jejor/ECE411-Fall2020/Schematics/README.md

# Eagle Schematics & Boards

## Valve Indicator

Purpose:
This board will collect valve position data using hall effect sensors mounted on nine solenoid valves and will report the current commanded state of the valves. 
The processor will compare the expected valve states with the currect reported valve states, 
if the states do not match the processor will output an indication over the LED arrays.
The LED arrays will display specific binary codes to indicate which valve does not match. 
If multiple valves do not match then the LED arrays will display all binary codes one after another based upon priority information.

Inputs:
- POE+ 24V Power
- UART Data
- Nine Hall Effect Sensors
- ST-Link V2 Emulator

Processor:
- STM32F042K

Outputs:
- Three LED Arrays
- One Buzzer
- SD Card Data Backup

### Libraries In Use

- Power Regulators: Diodes Inc. - AZ34063UMTR-G1.lbr
- Test Points: oresat-misc.lbr
- Processor: U-ST-STM32F042K-uC.lbr
- JTAG Emulator Connector: J-Samtec-FTSH-105-XXX-DV-K-ARM-SWD.lbr
- Diode: On Semiconductor - 1N5819G.lbr

### Design Rules

We are using the OshPark design rules for a 2-layer board.
