jejor/ECE411-Fall2020/Schematics/ece411_schemas/valve_indicator.brd

## EAGLE design Schematics/ece411_schemas/valve_indicator.brd (2020-12-07)

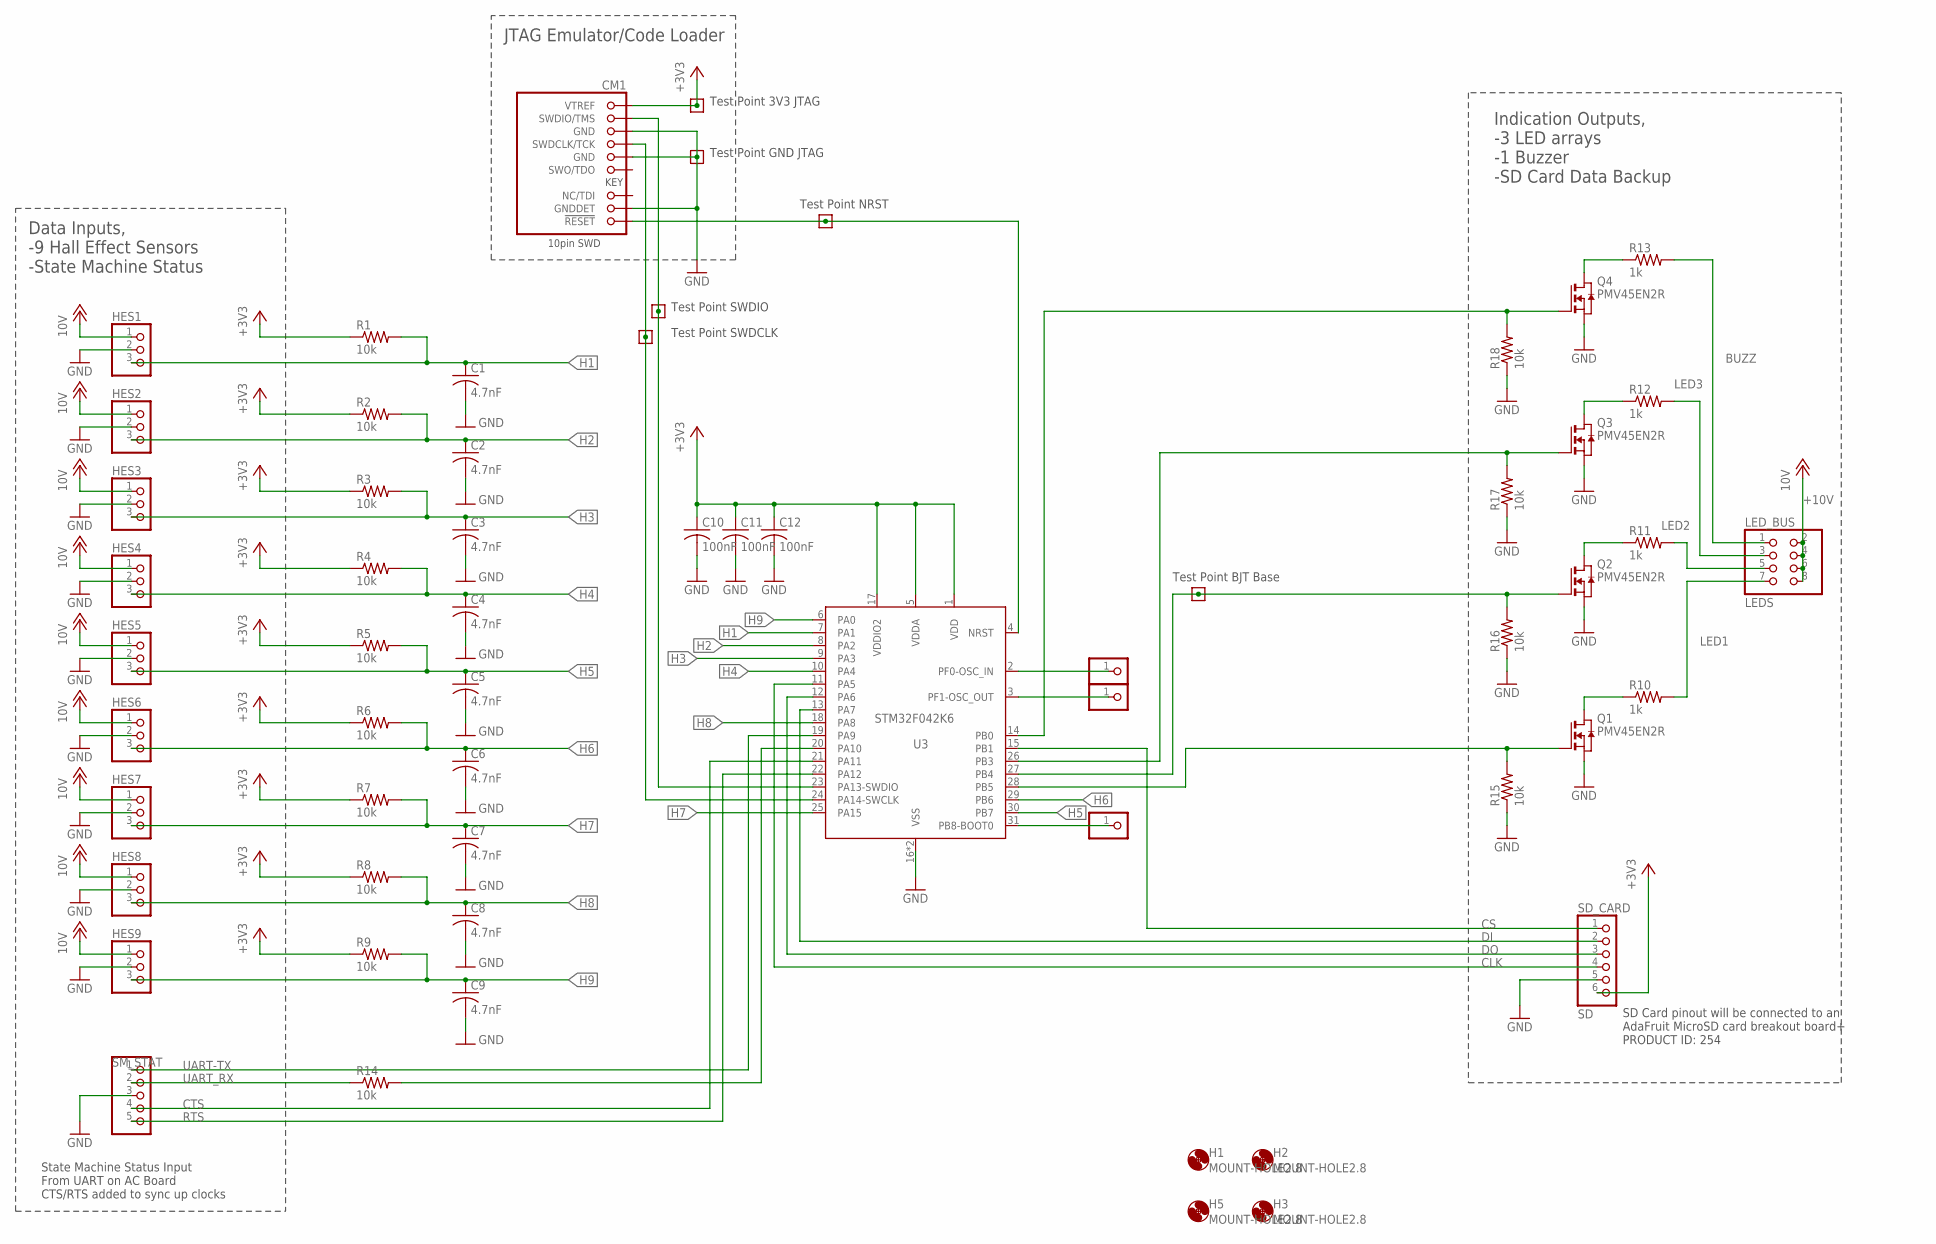
[picture p5: schematic valve_indicator.sch, sheet 1, Processor]

Parts:
C1, C2, C3, C4, C5, C6, C7, C8, C9: 4.7nF; C0603; MPN C1608C0G1H472J080AA
C10, C11, C12: 100nF; C0603; MPN CL10B104KA8NNNC
CM1: FTSH-105-XX-X-DV-K; CON10_2X5_DUK_FTSH; MPN FTSH-105-01-F-DV-K-TR
H1, H2, H3, H5: MOUNT-HOLE2.8; 2,8
HES1: HES1; 1X03; MPN 0022112032
HES2: HES2; 1X03; MPN 0022112032
HES3: HES3; 1X03; MPN 0022112032
HES4: HES4; 1X03; MPN 0022112032
HES5: HES5; 1X03; MPN 0022112032
HES6: HES6; 1X03; MPN 0022112032
HES7: HES7; 1X03; MPN 0022112032
HES8: HES8; 1X03; MPN 0022112032
HES9: HES9; 1X03; MPN 0022112032
JP2: PF0-OSC_IN_PIN; 1X01
JP3: PF1-OSC_OUT_PIN; 1X01
JP4: PB8-BOOT0_PIN; 1X01
LED_BUS: LEDS; 2X04
Q1, Q2, Q3, Q4: PMV45EN2R; SOT23; MPN PMV45EN2R
R1, R2, R3, R4, R5, R6, R7, R8, R9, R14, R15, R16, R17, R18: 10k; R0603; MPN RMCF0603FT10K0
R10, R11, R12, R13: 1k; R0603; MPN RMCF0603JJ1K00
SD_CARD: SD; 1X06; MPN 5-103635-5
SM_STAT: SM_STAT; 1X05; MPN 0022112032
TP3V3J: TEST-POINT-LARGE-SQUARE; 1X01
TPBASE: TEST-POINT-LARGE-SQUARE; 1X01
TPJGND: TEST-POINT-LARGE-SQUARE; 1X01
TPNRST: TEST-POINT-LARGE-SQUARE; 1X01
TPSCLK: TEST-POINT-LARGE-SQUARE; 1X01
TPSIO: TEST-POINT-LARGE-SQUARE; 1X01
U3: STM32F042K6; QFP32-7X7; MPN STM32F042K6T6

Connections:
+3V3: C10.1, C11.1, C12.1, CM1.1 (VTREF), R1.1, R2.1, R3.1, R4.1, R5.1, R6.1, R7.1, R8.1, R9.1, SD_CARD.6, TP3V3J.1, U3.1 (VDD), U3.5 (VDDA), U3.17 (VDDIO2); also elsewhere on the board
+10V: HES1.1, HES2.1, HES3.1, HES4.1, HES5.1, HES6.1, HES7.1, HES8.1, HES9.1, LED_BUS.2, LED_BUS.4, LED_BUS.6, LED_BUS.8; also elsewhere on the board
BUZZ: LED_BUS.1, R13.2
CLK: SD_CARD.4, U3.11 (PA5)
CS: SD_CARD.1, U3.15 (PB1)
CTS: SM_STAT.4, U3.21 (PA11)
DI: SD_CARD.2, U3.13 (PA7)
DO: SD_CARD.3, U3.12 (PA6)
GND: C1.2, C2.2, C3.2, C4.2, C5.2, C6.2, C7.2, C8.2, C9.2, C10.2, C11.2, C12.2, CM1.3 (GND), CM1.5 (GND), CM1.9 (GNDDET), HES1.2, HES2.2, HES3.2, HES4.2, HES5.2, HES6.2, HES7.2, HES8.2, HES9.2, Q1.2 (S), Q2.2 (S), Q3.2 (S), Q4.2 (S), R15.1, R16.1, R17.1, R18.1, SD_CARD.5, SM_STAT.3, TPJGND.1, U3.16 (VSS), U3.32 (VSS); also elsewhere on the board
H1: C1.1, HES1.3, R1.2, U3.7 (PA1)
H2: C2.1, HES2.3, R2.2, U3.8 (PA2)
H3: C3.1, HES3.3, R3.2, U3.9 (PA3)
H4: C4.1, HES4.3, R4.2, U3.10 (PA4)
H5: C5.1, HES5.3, R5.2, U3.30 (PB7)
H6: C6.1, HES6.3, R6.2, U3.29 (PB6)
H7: C7.1, HES7.3, R7.2, U3.25 (PA15)
H8: C8.1, HES8.3, R8.2, U3.18 (PA8)
H9: C9.1, HES9.3, R9.2, U3.6 (PA0)
LED1: LED_BUS.7, R10.2
LED2: LED_BUS.5, R11.2
LED3: LED_BUS.3, R12.2
unnamed: Q4.3 (D), R13.1
unnamed: JP2.1, U3.2 (PF0-OSC_IN)
unnamed: JP3.1, U3.3 (PF1-OSC_OUT)
unnamed: JP4.1, U3.31 (PB8-BOOT0)
unnamed: CM1.4 (SWDCLK/TCK), TPSCLK.1, U3.24 (PA14-SWCLK)
unnamed: Q3.3 (D), R12.1
unnamed: Q1.1 (G), R15.2, U3.28 (PB5)
unnamed: Q3.1 (G), R17.2, U3.26 (PB3)
unnamed: Q1.3 (D), R10.1
unnamed: Q2.3 (D), R11.1
unnamed: CM1.2 (SWDIO/TMS), TPSIO.1, U3.23 (PA13-SWDIO)
unnamed: CM1.10 (!RESET), TPNRST.1, U3.4 (NRST)
unnamed: Q4.1 (G), R18.2, U3.14 (PB0)
unnamed: Q2.1 (G), R16.2, TPBASE.1, U3.27 (PB4)
RTS: SM_STAT.5, U3.22 (PA12)
UART-RX: R14.2, U3.20 (PA10)
UART-TX: SM_STAT.1, U3.19 (PA9)
UART_RX: R14.1, SM_STAT.2

Notes on the sheet:
State Machine Status Input From UART on AC Board CTS/RTS added to sync up clocks
Data Inputs, -9 Hall Effect Sensors -State Machine Status
Indication Outputs, -3 LED arrays -1 Buzzer -SD Card Data Backup
JTAG Emulator/Code Loader
Test Point 3V3 JTAG
Test Point GND JTAG
Test Point NRST
Test Point SWDCLK
Test Point SWDIO
Test Point BJT Base
SD Card pinout will be connected to an AdaFruit MicroSD card breakout board+ PRODUCT ID: 254

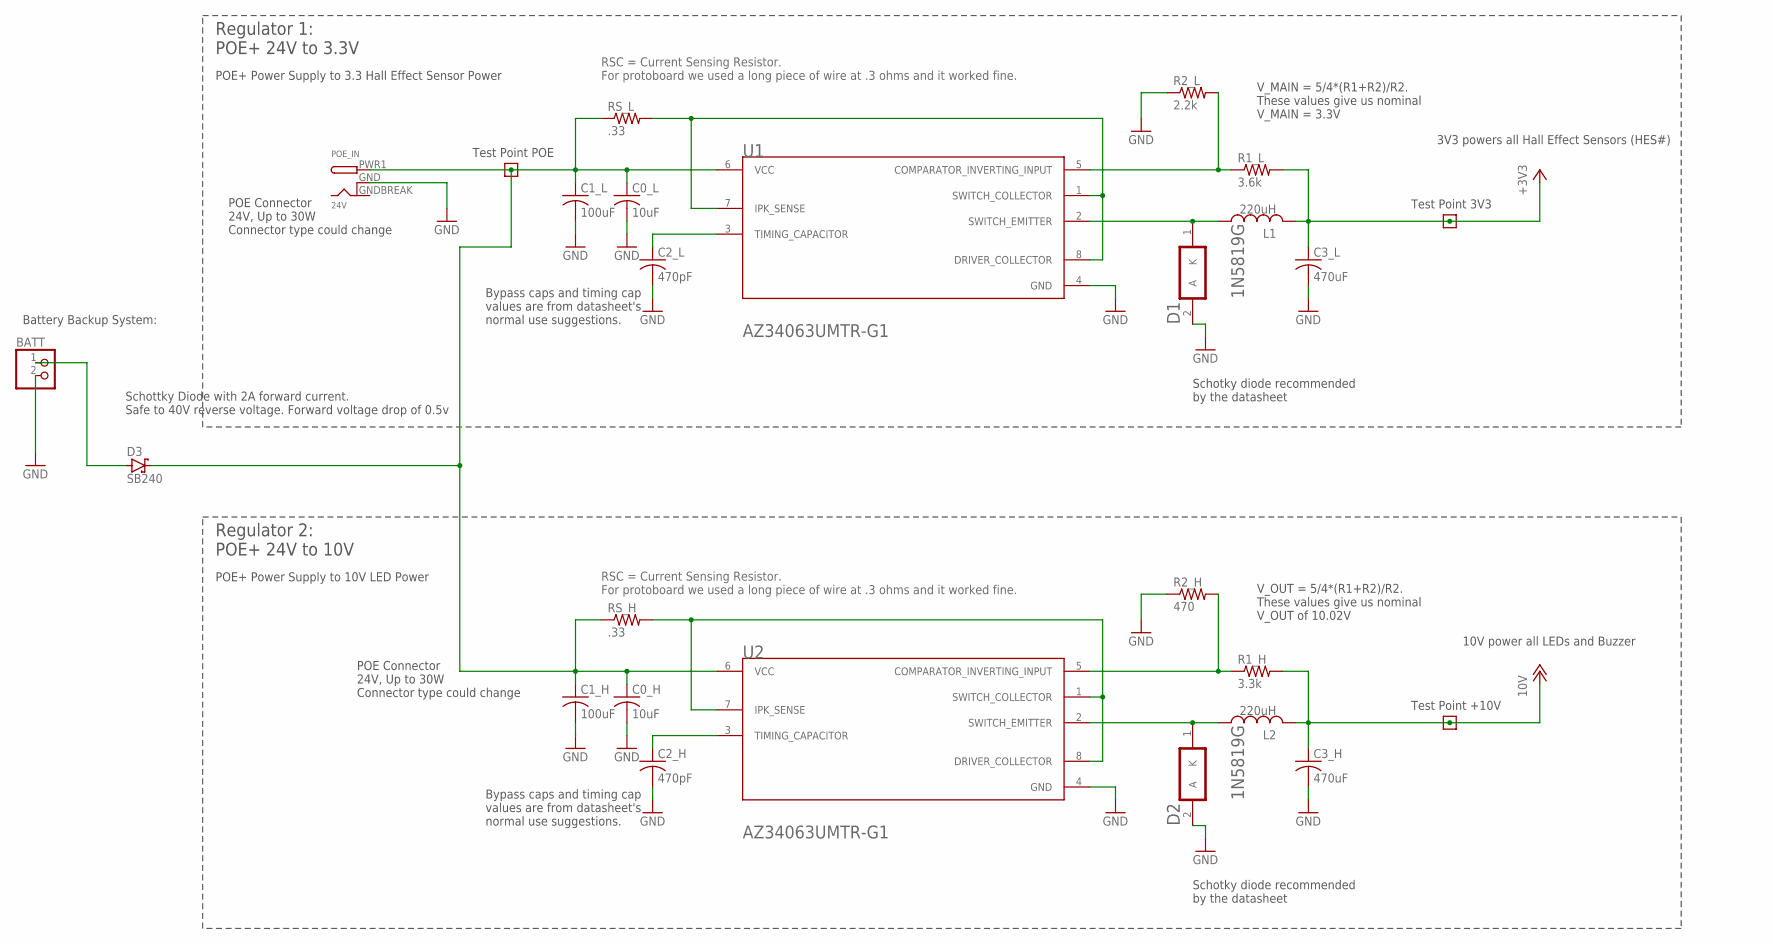
[picture p6: schematic valve_indicator.sch, sheet 2, Power Regulators]

Parts:
BATT: LED1; 1X02; MPN 0022232021
C0_H, C0_L: 10uF; C1206; MPN CL31A106MBHNNNE
C1_H, C1_L: 100uF; C025-025X050; MPN 107CKR050M
C2_H, C2_L: 470pF; C0603; MPN 0603B471K500CT
C3_H, C3_L: 470uF; C025-025X050; MPN ESH477M050AH4AA
D1, D2: 1N5819G_0_0; ON_SEMICONDUCTOR_1N5819G_0
D3: SB240; DO41-7.6; MPN SB240-E3/54
L1, L2: 220uH; 0204/5; MPN 12RS224C
POE_IN: 24V; DCJACK_2MM_SMT
R1_H: 3.3k; R0603; MPN RC0603FR-073K3L
R1_L: 3.6k; R0603; MPN RC0603FR-073K6L
R2_H: 470; R0603; MPN CRGCQ0603F470R
R2_L: 2.2k; R0603; MPN ERJ-3EKF2201V
RS_H: .33; R0603; MPN ERJ-3RQFR33V
RS_L: .33; R0603; MPN ERJ-3RQFR33V
TP3V3, TP10V: TEST-POINT-LARGE-SQUARE; 1X01
TPOE: TEST-POINT-LARGE-SQUARE; 1X01
U1, U2: AZ34063UMTR-G1; DIODES_INC._AZ34063UMTR-G1_0

Connections:
+3V3: C3_L.1, L1.2, R1_L.2, TP3V3.1; also elsewhere on the board
+10V: C3_H.1, L2.2, R1_H.2, TP10V.1; also elsewhere on the board
GND: BATT.2, C0_H.2, C0_L.2, C1_H.2, C1_L.2, C2_H.2, C2_L.2, C3_H.2, C3_L.2, D1.2 (A), D2.2 (A), POE_IN.GND (GNDBREAK), POE_IN.GNDBREAK (GND), R2_H.1, R2_L.1, U1.4 (GND), U2.4 (GND); also elsewhere on the board
unnamed: RS_L.2, U1.1 (SWITCH_COLLECTOR), U1.7 (IPK_SENSE), U1.8 (DRIVER_COLLECTOR)
unnamed: C2_L.1, U1.3 (TIMING_CAPACITOR)
unnamed: R1_L.1, R2_L.2, U1.5 (COMPARATOR_INVERTING_INPUT)
unnamed: D1.1 (K), L1.1, U1.2 (SWITCH_EMITTER)
unnamed: D2.1 (K), L2.1, U2.2 (SWITCH_EMITTER)
unnamed: BATT.1, D3.A
unnamed: RS_H.2, U2.1 (SWITCH_COLLECTOR), U2.7 (IPK_SENSE), U2.8 (DRIVER_COLLECTOR)
unnamed: C2_H.1, U2.3 (TIMING_CAPACITOR)
unnamed: R1_H.1, R2_H.2, U2.5 (COMPARATOR_INVERTING_INPUT)
POE: C0_H.1, C0_L.1, C1_H.1, C1_L.1, D3.C, POE_IN.PWR1 (PWR), RS_H.1, RS_L.1, TPOE.1, U1.6 (VCC), U2.6 (VCC)

Notes on the sheet:
POE Connector 24V, Up to 30W Connector type could change
Bypass caps and timing cap values are from datasheet's normal use suggestions.
V_MAIN = 5/4*(R1+R2)/R2. These values give us nominal V_MAIN = 3.3V
Schotky diode recommended by the datasheet
Regulator 1: POE+ 24V to 3.3V
3V3 powers all Hall Effect Sensors (HES#)
POE+ Power Supply to 3.3 Hall Effect Sensor Power
V_OUT = 5/4*(R1+R2)/R2. These values give us nominal V_OUT of 10.02V
Regulator 2: POE+ 24V to 10V
10V power all LEDs and Buzzer
POE+ Power Supply to 10V LED Power
Battery Backup System:
Schottky Diode with 2A forward current. Safe to 40V reverse voltage. Forward voltage drop of 0.5v
Test Point 3V3
Test Point +10V
Test Point POE
RSC = Current Sensing Resistor. For protoboard we used a long piece of wire at .3 ohms and it worked fine.

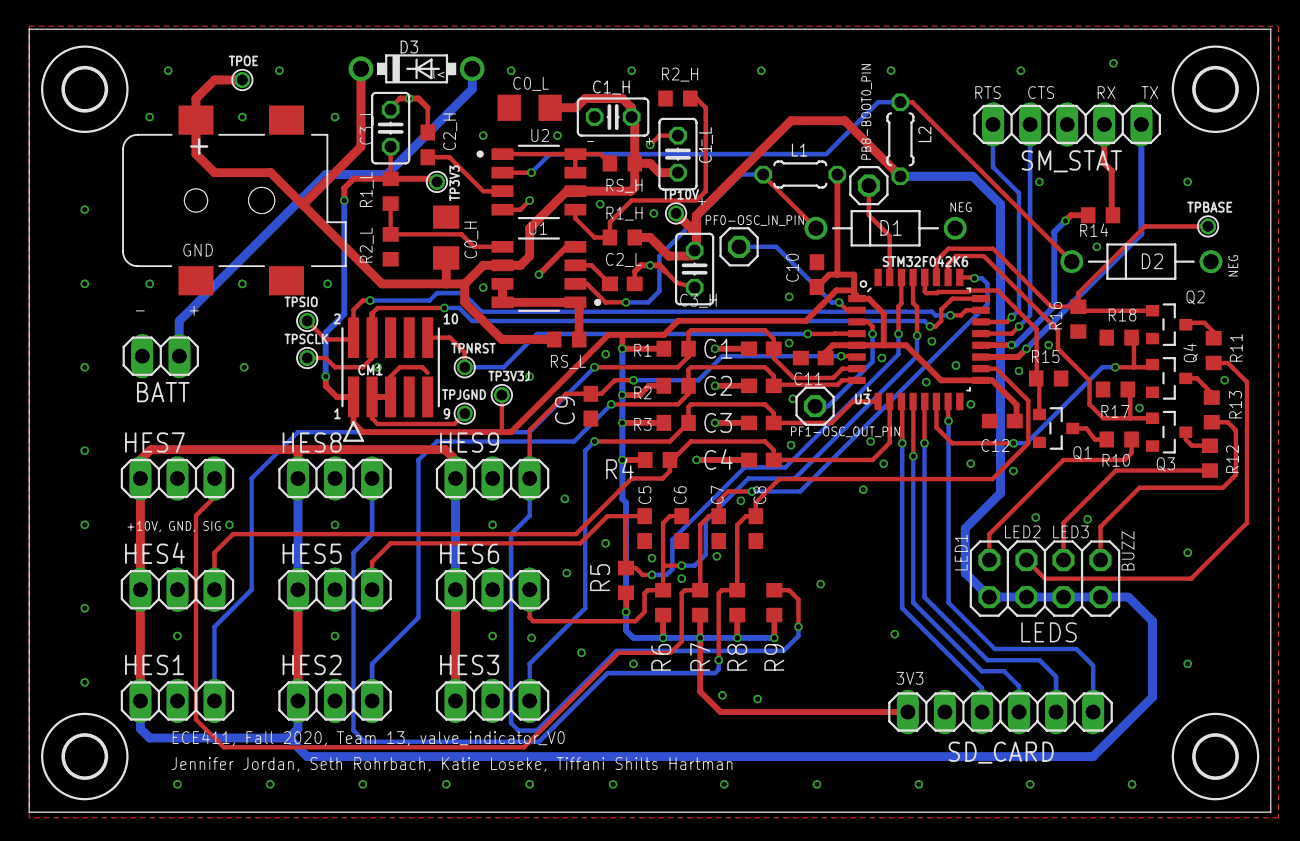
[picture p7: board valve_indicator.brd from above]

Board: 2 copper layers, 85.1 x 53.6 mm, 87 parts (0 on the bottom side), 49 nets.
