jejor/ECE411-Fall2020/(threads)

Thread 1 (2020-10-30):

Correct Resistor Values

jejor, 2020-10-30:
Change the resistor values for the power regulators to match 3.7V out and 10V out.

sethrohrbach, 2020-10-30:
fix't

Closed 2020-10-30.

Thread 2 (2020-10-30):

Source and Replace TH with SMD

jejor, 2020-10-30:
Res, Cap, Ind need to be changed to SMD. Find parts and replace in Schematic

sethrohrbach, 2020-10-30:
resistors and capacitors updated. requested inductor EAGLE part, waiting on that.

jejor, 2020-11-05:
done

Closed 2020-11-05.

Thread 6 (2020-11-29):

Fix c3_h and c3_l component pads. Relayout board to compensate for space

jejor, 2020-11-29:

jejor, 2020-11-29:
DPN is for through hole instead of SMD. Need to either find SMD that would fit or change pads to TH.

Closed 2020-11-29.
