jejor/ECE411-Fall2020/Software/TSAR2.0/TSAR2.0.ioc

Mcu.UserName=STM32F042K6Ux
PA0.GPIO_Label=Hall Effect Sensor Nine
PA0.Signal=GPIO_Input
PA1.GPIO_Label=Hall Effect Sensor One
PA1.Signal=GPIO_Input
PA15.GPIO_Label=Hall Effect Sensor Seven
PA15.Signal=GPIO_Input
PA2.GPIO_Label=Hall Effect Sensor Two
PA2.Signal=GPIO_Input
PA3.GPIO_Label=Hall Effect Sensor Three
PA3.Signal=GPIO_Input
PA4.GPIO_Label=Hall Effect Sensor Four
PA4.Signal=GPIO_Input
PA5.Signal=SPI1_SCK
PA6.Signal=SPI1_MISO
PA7.Signal=SPI1_MOSI
PA8.GPIO_Label=Hall Effect Sensor Eight
PA8.Signal=GPIO_Input
PB0.GPIO_Label=Buzzer
PB0.Signal=GPIO_Output
PB1.GPIO_Label=SD_CS
PB1.Signal=GPIO_Output
PB3.GPIO_Label=LED Three
PB3.Signal=GPIO_Output
PB4.GPIO_Label=LED Two
PB4.Signal=GPIO_Output
PB5.GPIO_Label=LED One
PB5.Signal=GPIO_Output
PB6.GPIO_Label=Hall Effect Sensor Six
PB6.Signal=GPIO_Input
PB7.GPIO_Label=Hall Effect Sensor Five
PB7.Signal=GPIO_Input
