jejor/ECE411-Fall2020/(commit log)

2020-10-24 -Added 1st pass for main power supply schematic
    [power_supply_schema.sch]
2020-10-30 Not 100% sure how much of the project is needed so I'm just putting the whole project folder in
    [power_supply_schema.sch]
2020-10-30 moved this into the project folder
    [power_supply_schema.sch]
2020-10-30 combined eagle files
    combined seth's power system and processor schematic into one file with multiple sheets.
    [valve_indicator.brd, valve_indicator.sch]
2020-10-30 swapped PTH to SMD 0603 components, fixed resistor values for 10v regulator.
    waiting on eagle library for the inductor, couldn't find an 0603 package 220 uH rated for enough current so I picked a shielded package
    [valve_indicator.sch]
2020-10-31 began layout of board
    also added components attributes
2020-11-01 board layout done
    [valve_indicator.brd, valve_indicator.sch]
2020-11-01 dru added, added attributes
    [valve_indicator.brd, valve_indicator.sch]
2020-11-02 created bom, finished attributes
    [BOM.csv, valve_indicator.brd, valve_indicator.sch]
2020-11-02 updated board bom
    [BOM.csv, valve_indicator.brd, valve_indicator.sch]
2020-11-02 added nrst pin to jtag emul
2020-11-02 added bypass caps, updated bom
    needed to add 10uF ceramic in parallel with 100uF electro caps to decrease resistance to ground
    [BOM.csv, valve_indicator.brd, valve_indicator.sch]
2020-11-02 added bat backup
    [valve_indicator.sch]
2020-11-03 updates to board, added libraries
    [valve_indicator.brd, valve_indicator.sch]
2020-11-04 updated board
    [valve_indicator.brd, valve_indicator.sch]
2020-11-05 bom, layout, attribute, device
    added attributes to rest of parts
    made power lines thicker for dissapation
    editted az34.. device to remedy errors
    added test points
    [BOM.csv, valve_indicator.brd, valve_indicator.sch]
2020-11-06 readme for schematics/boards
2020-11-06 added state machine uart conn, labels
    [valve_indicator.brd, valve_indicator.sch]
2020-11-06 updated inductor part
    [BOM.csv, valve_indicator.brd, valve_indicator.sch]
2020-11-07 added test code to make an ledblink on in PB3
    [stm_blinky Run.cfg]
2020-11-09 updated board given feedback
    [valve_indicator.brd, valve_indicator.sch]
2020-11-09 updated inductor attributes, some note updates on power sheet
    [valve_indicator.brd]
2020-11-09 digikey --> digi-key
    [valve_indicator.sch]
2020-11-10 fixed issues with board, updated BOM
    [BOM.csv, valve_indicator.brd, valve_indicator.sch]
2020-11-11 updated power lines
    [valve_indicator.brd, valve_indicator.sch]
2020-11-15 initial code setup for uart and sd card
2020-11-16 fixed error on board
    [valve_indicator.brd, valve_indicator.sch]
2020-11-16 added cts/rts, cleanup, added backup pins
    Added cts/rts to uart pin bus, cleaned up the schematic nets, and added pins for all the unused stm pins just in case.
    [valve_indicator.brd, valve_indicator.sch]
2020-11-18 fixed silkscreen
    [valve_indicator.brd]
2020-11-27 Led on logic for pushing pins
2020-11-29 corrections to board
    [valve_indicator.brd, valve_indicator.sch]
2020-12-02 working (hopefully) code for sensor/LED/buzzer UNTESTED
    [main.c]
2020-12-02 cleaner code more sd framework UNTESTED
2020-12-02 fixed silent error in line 186
    [main.c]
2020-12-02 SD functions inserted but too large currently T.T
    [main.c]
2020-12-03 Code for state machine and SD card compiling, not tested. Removed UART stub code for space temporarily.
2020-12-06 turned on SWD (serial wire debug in sys config)
2020-12-07 updates to spacing on boards
    [valve_indicator.brd, valve_indicator.sch]
